Thomas-Singer/Ampelparty-Ampel/Layout/Ampel.kicad_pcb

## KiCad design Layout/Ampel.kicad_pcb (2022-09-18)

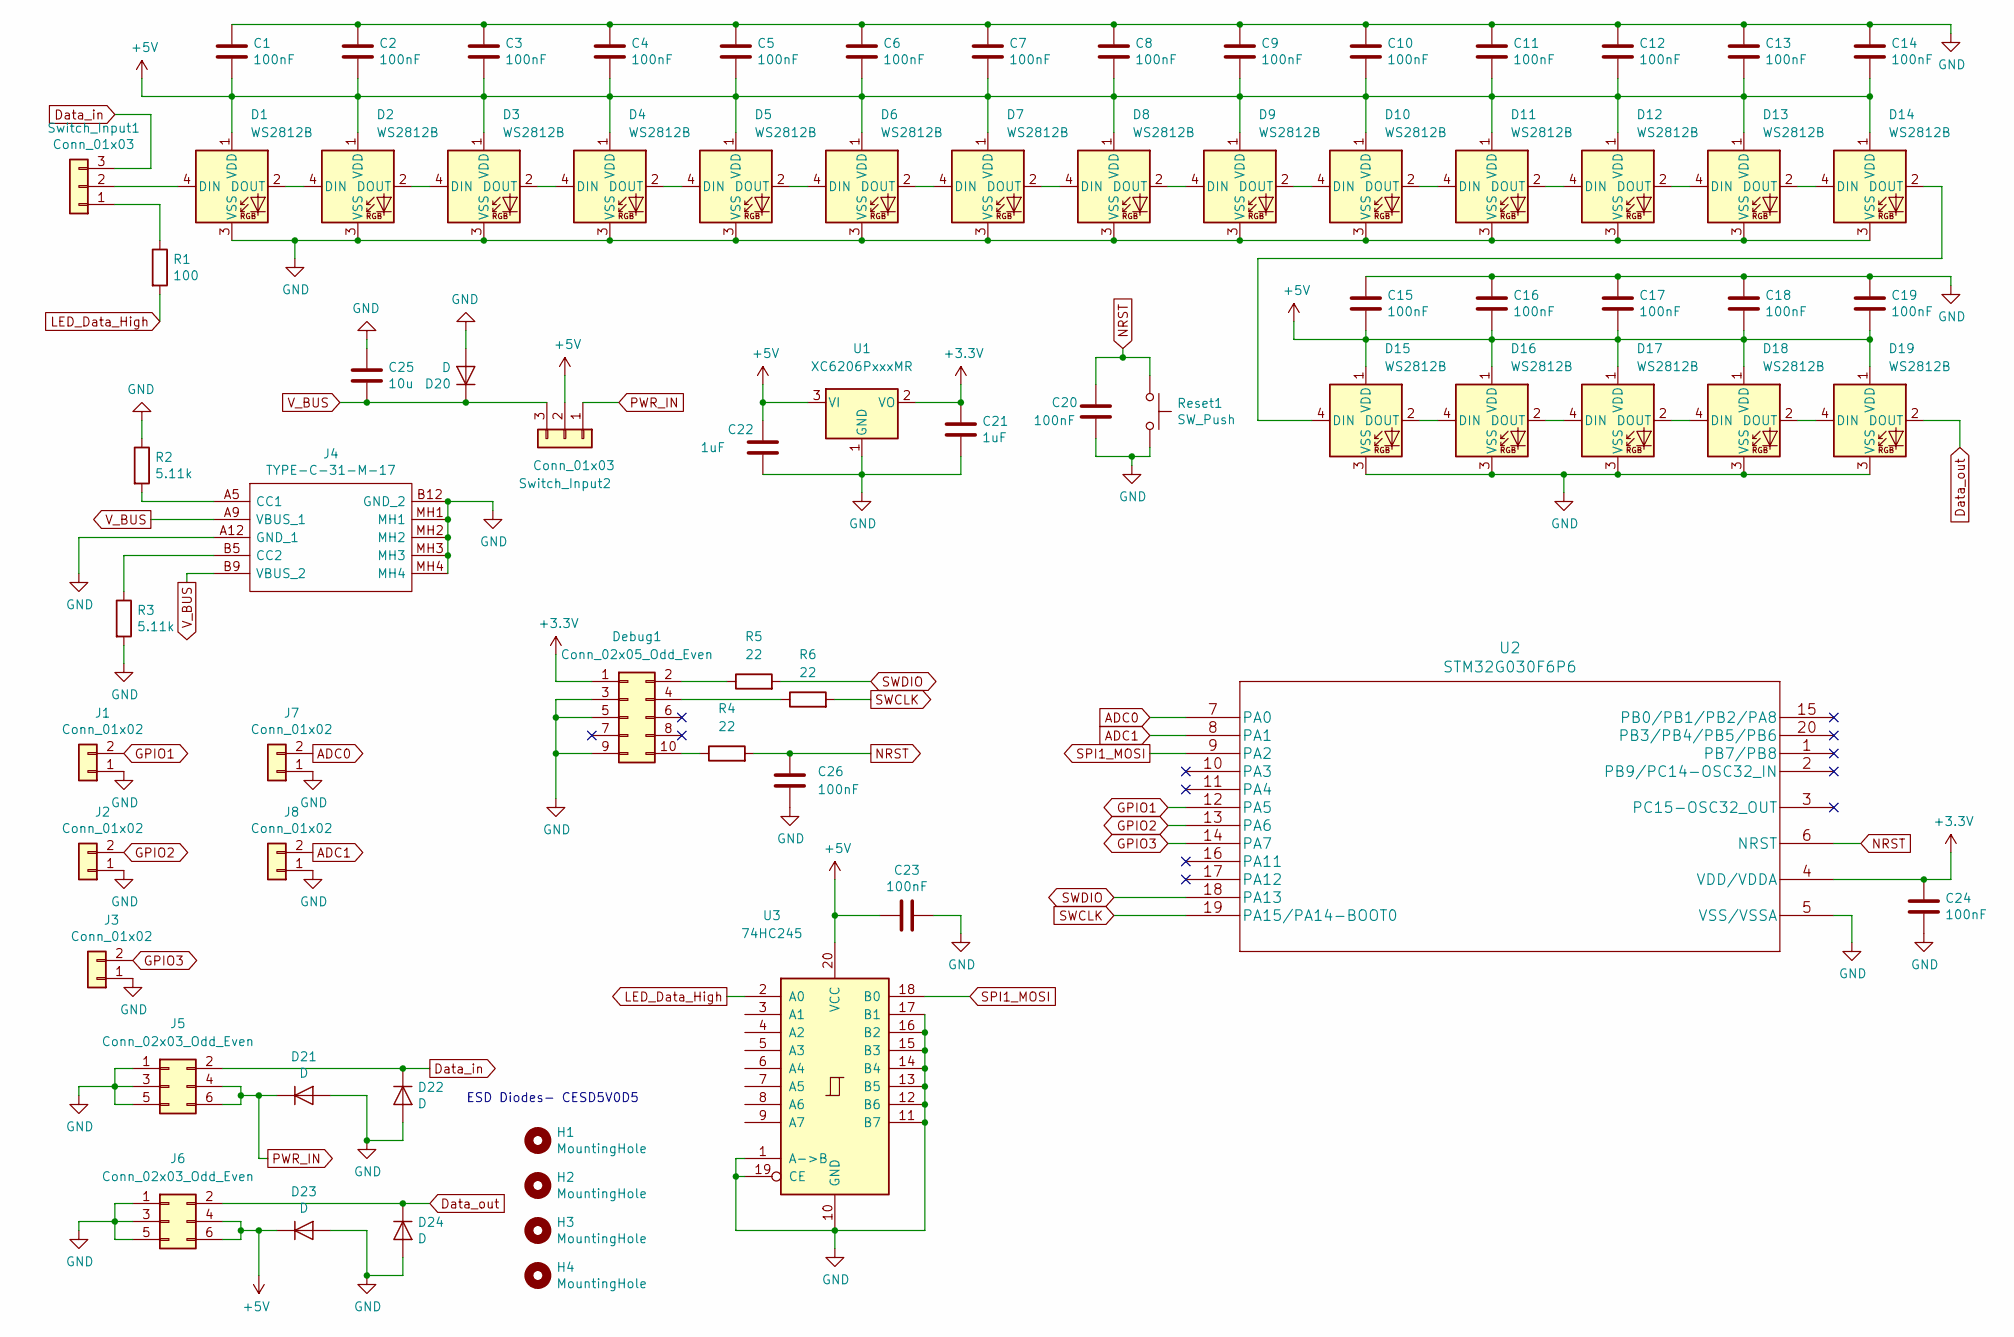
[picture p1: schematic Ampel.kicad_sch]

Parts:
C1, C2, C3, C4, C5, C6, C7, C8, C9, C10, C11, C12, C13, C14, C15, C16, C17, C18, C19, C20, C23, C24, C26: 100nF; C_0603_1608Metric
C21, C22: 1uF; C_0805_2012Metric
C25: 10u; C_1210_3225Metric
D1, D2, D3, D4, D5, D6, D7, D8, D9, D10, D11, D12, D13, D14, D15, D16, D17, D18, D19: WS2812B; LED_WS2812B_PLCC4_5.0x5.0mm_P3.2mm
D20, D21, D22, D23, D24: D; D_SOD-523
Debug1: Conn_02x05_Odd_Even; IDC-Header_2x05_P2.54mm_Vertical
H1, H2, H3, H4: MountingHole; MountingHole_3.5mm_Pad
J1, J2, J3, J7, J8: Conn_01x02; PinHeader_1x02_P2.54mm_Vertical
J4: TYPE-C-31-M-17; TYPEC31M17; Manufacturer_Part_Number TYPE-C-31-M-17
J5, J6: Conn_02x03_Odd_Even; IDC-Header_2x03_P2.54mm_Vertical
R1: 100; R_0603_1608Metric
R2, R3: 5.11k; R_0603_1608Metric
R4, R5, R6: 22; R_0603_1608Metric
Reset1: SW_Push; SW_SPST_EVPBF
Switch_Input1, Switch_Input2: Conn_01x03; PinHeader_1x03_P2.54mm_Vertical
U1: XC6206PxxxMR; SOT-23
U2: STM32G030F6P6; TSSOP-20_4.4x6.5mm_P0.65mm
U3: 74HC245; SSOP-20_5.3x7.2mm_P0.65mm

Connections:
+3V3: C21.1, C24.1, Debug1.1, U1.2 (VO), U2.4 (VDD/VDDA)
+5V: C1.1, C2.1, C3.1, C4.1, C5.1, C6.1, C7.1, C8.1, C9.1, C10.1, C11.1, C12.1, C13.1, C14.1, C15.1, C16.1, C17.1, C18.1, C19.1, C22.2, C23.2, D1.1 (VDD), D2.1 (VDD), D3.1 (VDD), D4.1 (VDD), D5.1 (VDD), D6.1 (VDD), D7.1 (VDD), D8.1 (VDD), D9.1 (VDD), D10.1 (VDD), D11.1 (VDD), D12.1 (VDD), D13.1 (VDD), D14.1 (VDD), D15.1 (VDD), D16.1 (VDD), D17.1 (VDD), D18.1 (VDD), D19.1 (VDD), D23.1 (K), J6.4, J6.6, Switch_Input2.2, U1.3 (VI), U3.20 (VCC)
ADC0: J7.2, U2.7 (PA0); also elsewhere on the board
ADC1: J8.2, U2.8 (PA1); also elsewhere on the board
Data_in: D22.1 (K), J5.2, Switch_Input1.3
Data_out: D19.2 (DOUT), D24.1 (K), J6.2
GND: C1.2, C2.2, C3.2, C4.2, C5.2, C6.2, C7.2, C8.2, C9.2, C10.2, C11.2, C12.2, C13.2, C14.2, C15.2, C16.2, C17.2, C18.2, C19.2, C20.2, C21.2, C22.1, C23.1, C24.2, C25.1, C26.2, D1.3 (VSS), D2.3 (VSS), D3.3 (VSS), D4.3 (VSS), D5.3 (VSS), D6.3 (VSS), D7.3 (VSS), D8.3 (VSS), D9.3 (VSS), D10.3 (VSS), D11.3 (VSS), D12.3 (VSS), D13.3 (VSS), D14.3 (VSS), D15.3 (VSS), D16.3 (VSS), D17.3 (VSS), D18.3 (VSS), D19.3 (VSS), D20.2 (A), D21.2 (A), D22.2 (A), D23.2 (A), D24.2 (A), Debug1.3, Debug1.5, Debug1.9, J1.1, J2.1, J3.1, J4.A12 (GND_1), J4.B12 (GND_2), J4.MH1, J4.MH2, J4.MH3, J4.MH4, J5.1, J5.3, J5.5, J6.1, J6.3, J6.5, J7.1, J8.1, R2.1, R3.2, Reset1.2, U1.1 (GND), U2.5 (VSS/VSSA), U3.1 (A->B), U3.10 (GND), U3.11 (B7), U3.12 (B6), U3.13 (B5), U3.14 (B4), U3.15 (B3), U3.16 (B2), U3.17 (B1), U3.19 (CE); also elsewhere on the board
GPIO1: J1.2, U2.12 (PA5); also elsewhere on the board
GPIO2: J2.2, U2.13 (PA6); also elsewhere on the board
GPIO3: J3.2, U2.14 (PA7); also elsewhere on the board
LED_Data_High: R1.2, U3.2 (A0)
NRST: C20.1, C26.1, R4.2, Reset1.1, U2.6 (NRST)
unnamed: D1.2 (DOUT), D2.4 (DIN)
unnamed: D1.4 (DIN), Switch_Input1.2
unnamed: D2.2 (DOUT), D3.4 (DIN)
unnamed: D3.2 (DOUT), D4.4 (DIN)
unnamed: D4.2 (DOUT), D5.4 (DIN)
unnamed: D5.2 (DOUT), D6.4 (DIN)
unnamed: D6.2 (DOUT), D7.4 (DIN)
unnamed: D7.2 (DOUT), D8.4 (DIN)
unnamed: D8.2 (DOUT), D9.4 (DIN)
unnamed: D10.2 (DOUT), D11.4 (DIN)
unnamed: D9.2 (DOUT), D10.4 (DIN)
unnamed: D11.2 (DOUT), D12.4 (DIN)
unnamed: D12.2 (DOUT), D13.4 (DIN)
unnamed: D13.2 (DOUT), D14.4 (DIN)
unnamed: D14.2 (DOUT), D15.4 (DIN)
unnamed: D15.2 (DOUT), D16.4 (DIN)
unnamed: D16.2 (DOUT), D17.4 (DIN)
unnamed: D17.2 (DOUT), D18.4 (DIN)
unnamed: D18.2 (DOUT), D19.4 (DIN)
unnamed: Debug1.2, R5.1
unnamed: Debug1.4, R6.1
unnamed: Debug1.10, R4.1
unnamed: J4.A5 (CC1), R2.2
unnamed: J4.B5 (CC2), R3.1
unnamed: R1.1, Switch_Input1.1
PWR_IN: D21.1 (K), J5.4, J5.6, Switch_Input2.1
SPI1_MOSI: U2.9 (PA2), U3.18 (B0)
SWCLK: R6.2, U2.19 (PA15/PA14-BOOT0)
SWDIO: R5.2, U2.18 (PA13)
V_BUS: C25.2, D20.1 (K), J4.A9 (VBUS_1), J4.B9 (VBUS_2), Switch_Input2.3

Notes on the sheet:
ESD Diodes- CESD5V0D5

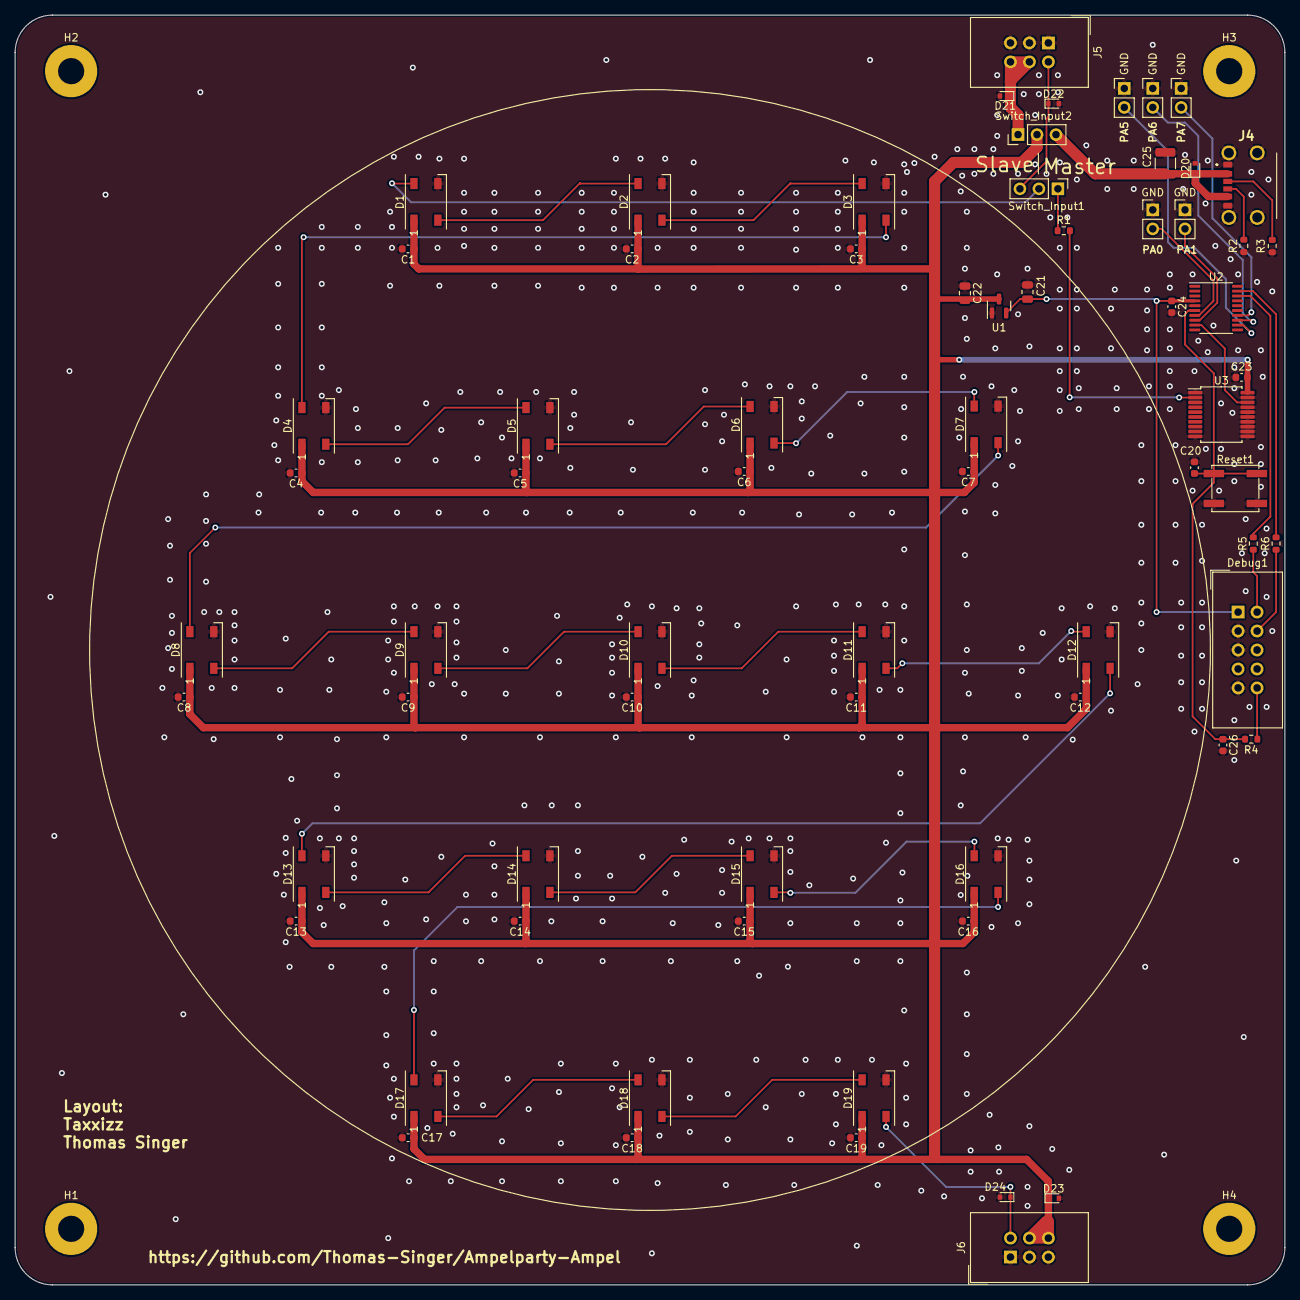
[picture p2: board Ampel.kicad_pcb from above]

Board: 2 copper layers, 170.0 x 170.0 mm, 75 parts (0 on the bottom side), 42 nets.

Other parts of the board:
GND: Conn_01x02; PinHeader_1x02_P2.54mm_Vertical
GND#2, GND#3, GND#4, GND#5: Conn_01x02; PinHeader_1x02_P2.54mm_Vertical

Their connections:
ADC0: GND#4.2; also elsewhere on the board
ADC1: GND#5.2; also elsewhere on the board
GND: GND.1, GND#2.1, GND#3.1, GND#4.1, GND#5.1; also elsewhere on the board
GPIO1: GND.2; also elsewhere on the board
GPIO2: GND#2.2; also elsewhere on the board
GPIO3: GND#3.2; also elsewhere on the board
