Thomas-Singer/Ampelparty-Ampel/Code/Ampelparty-Ampel.ioc

Mcu.UserName=STM32G030F6Px
PA13.Signal=SYS_SWDIO
PA14-BOOT0.Signal=SYS_SWCLK
PA2.Signal=SPI1_MOSI
PB3.Signal=SPI1_SCK
