Thomas-Singer/Ampelparty-Ampel/(commit log)

2022-09-18 Final Layout
    [Ampel.kicad_pcb, Ampel.kicad_sch]
2022-10-12 Added WS2812b-IF, currently not working
    [Ampelparty-Ampel.ioc, ws2812b.c, ws2812b.h]
2022-10-17 control works now the NSSP mode of the SPI was the reason. So the clock waites sometimes which destroys the timing.
